celalkavlak/EE463_Hardware_Project/README.md

# EE463_Hardware_Project
Repository of EE463 Hardware Project
