celalkavlak/EE463_Hardware_Project/simulation results/sim results.docx

# SIMULATION RESULTS

## R-LOAD SIMULATION RESULTS

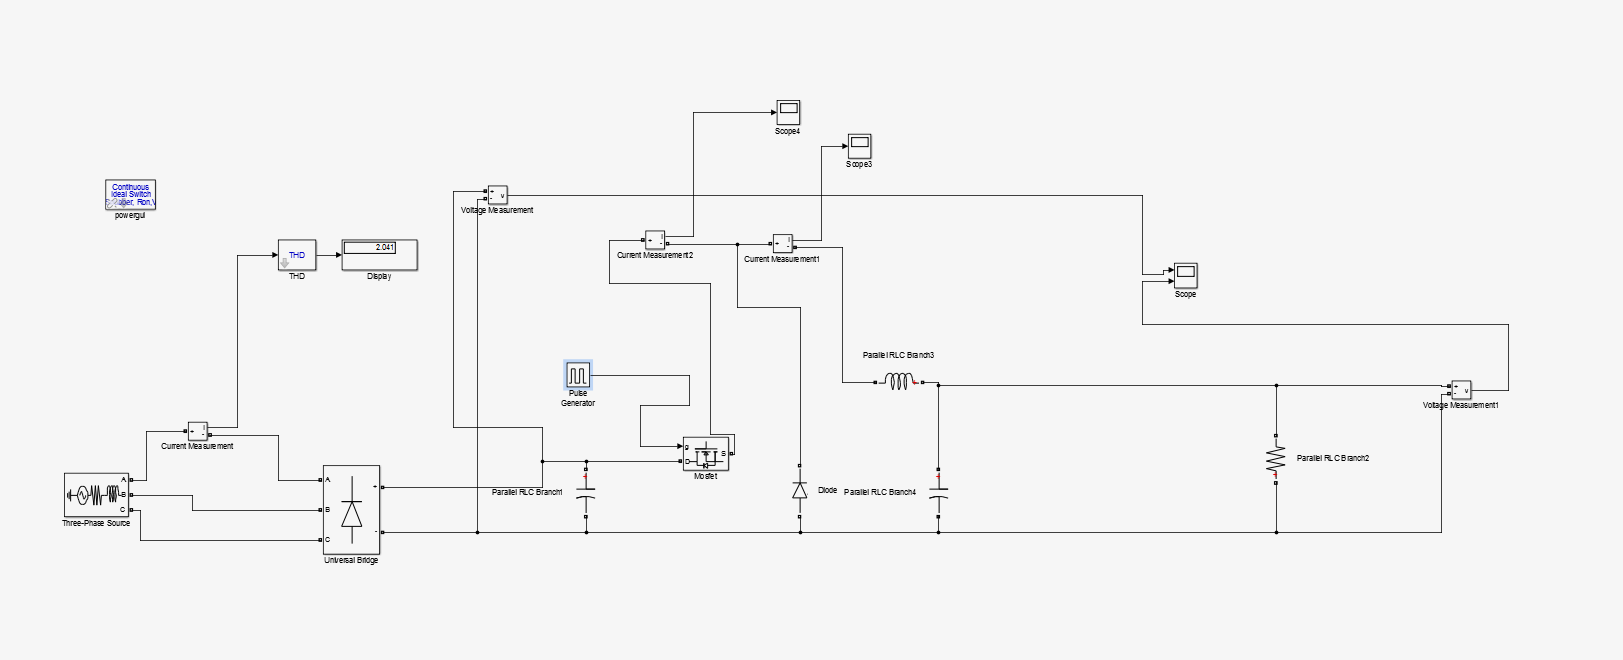
[picture p1: figure]

Figure 1. The circuit of AC to DC Motor Driver with R Load

THD is equal to %204.

The output voltage and rectifier voltage of system different with duty cycles are shown as follows;

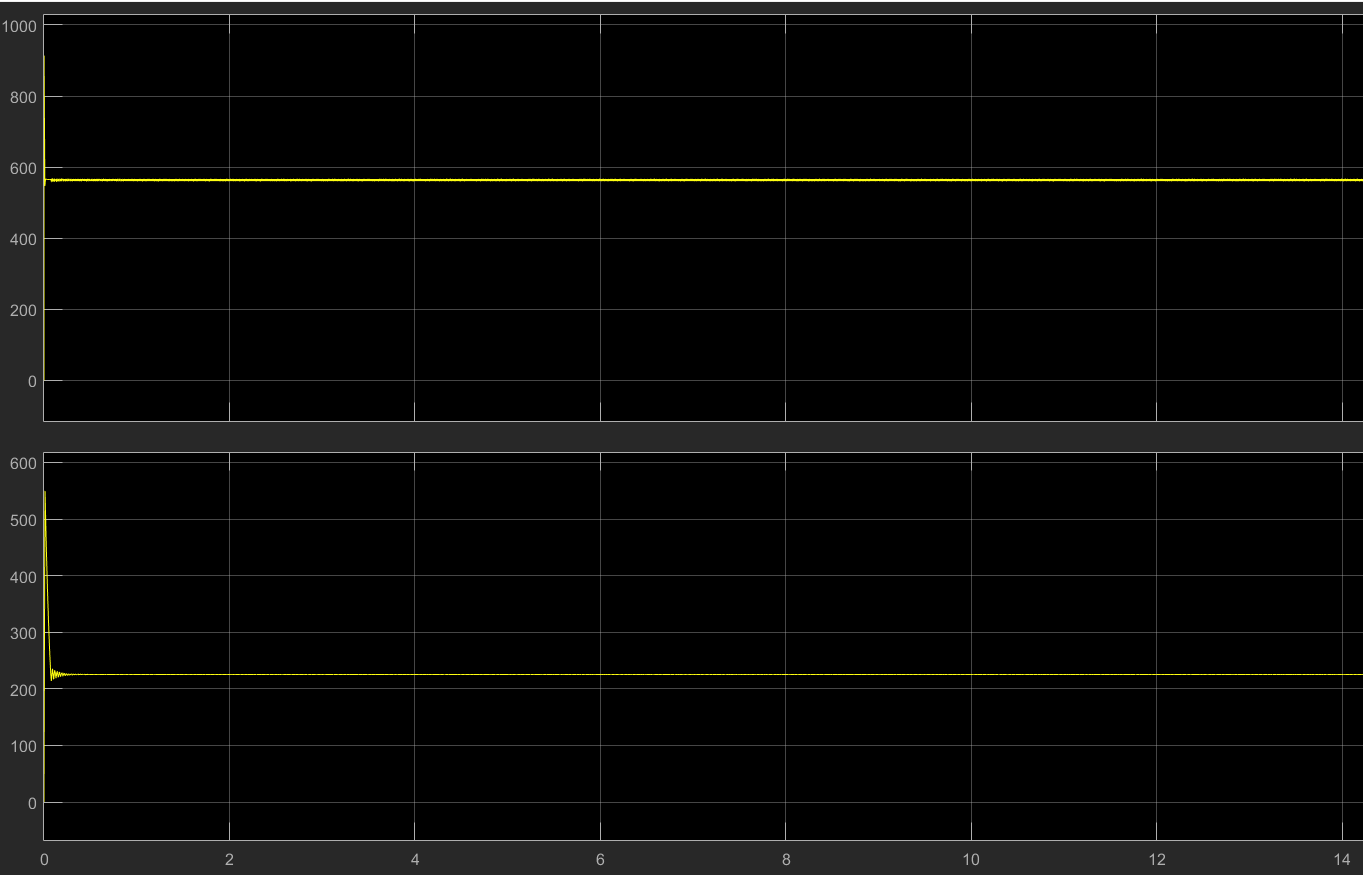
[picture p2: figure]

Figure 2.Output Voltage and Rectifier Voltages of R Load at %40 Duty Cycle

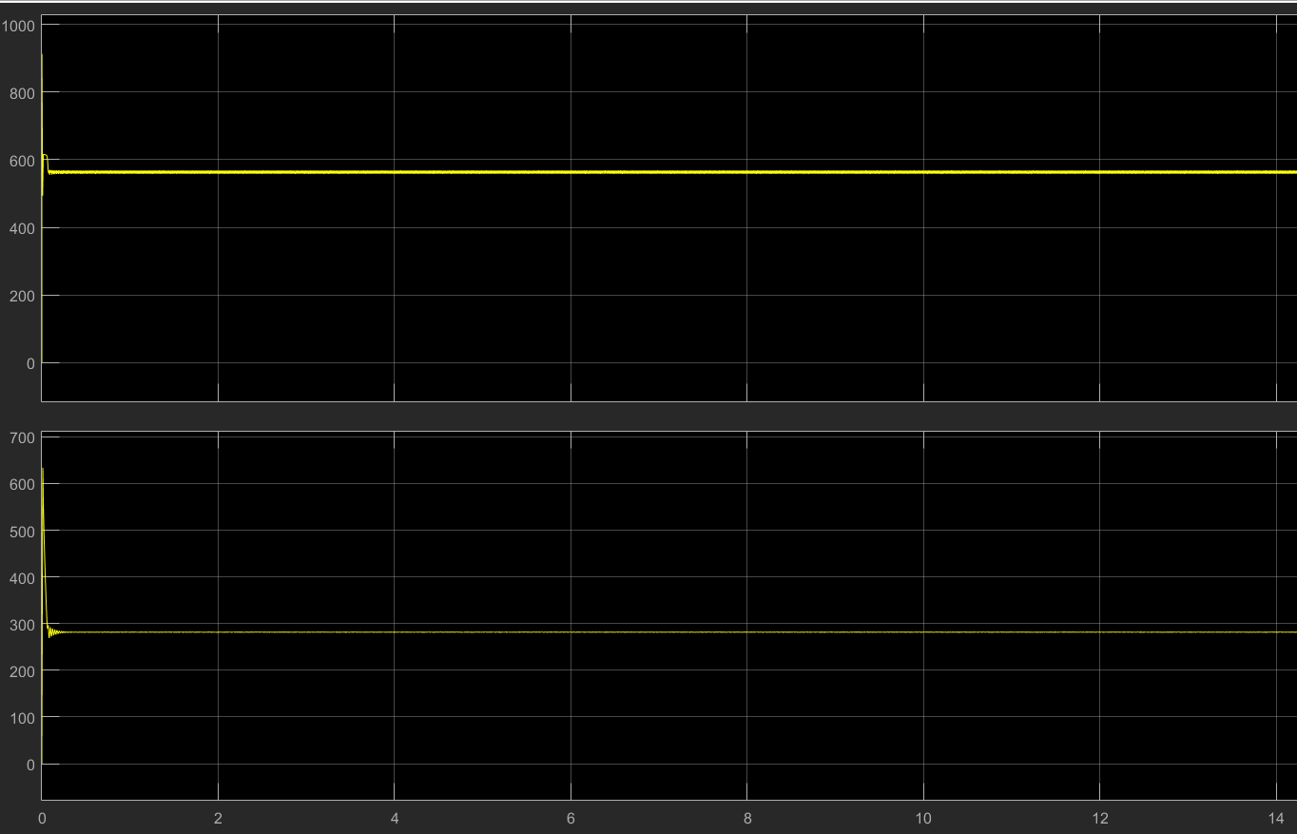
[picture p3: figure]

Figure 3.Output Voltage and Rectifier Voltages of R Load at %50 Duty Cycle

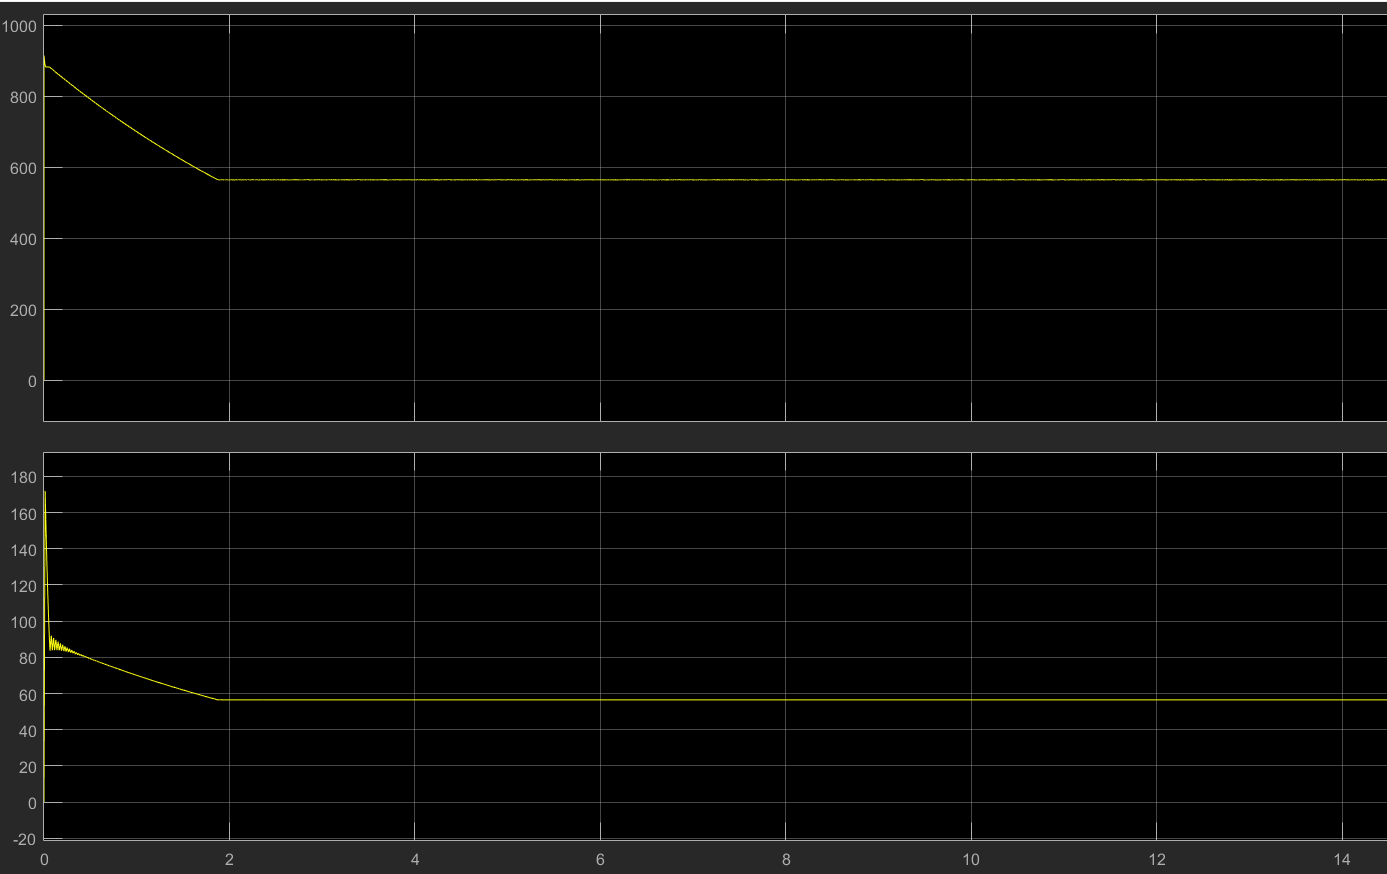
[picture p4: figure]

Figure 4.Output Voltage and Rectifier Voltages of R Load at %10 Duty Cycle
