celalkavlak/EE463_Hardware_Project/report/ee463 term project report of design and test results Abdurrahman Aydın-Tugay Karakaya- Celal Kavlak.pdf

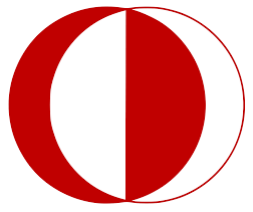
[picture p5: figure]

EE463

# STATIC POWER CONVERSION I

# REPORT OF TERM PROJECT DESIGN AND TEST RESULTS

# “AC TO DC MOTOR DRIVE”

## Abdurrahman Aydın 1936293

## Tugay Karakaya 1937069

## Celal KAVLAK 2030955

### Table of Contents

### Introduction

In this report; design decisions, computer simulations and component selection relevant to the 2017/2018 fall semester term project of Static Power Conversion I, named as AC to DC Motor Drive is provided. It is required to make a controlled rectifier that will be used drive a DC motor. The power input is three phase or one phase AC grid. The output is adjustable DC output.

### Design Decisions

In this stage, variety of different topologies is compared to reach the most efficient way to drive the DC motor at desired conditions.

### Comparison of Different Topologies

1) Single Phase Thyristor Rectifier
In thyristor rectifier, the advantage is the fact that drive is composed of fewer stages. Adjusting the average output voltage is made by setting firing angle. Moreover, in thyristor rectifiers, the motor can operate in 4th quadrant. However, gate drive of thyristor is very complicated. Generating two periodic pulse signals with 180 degree phase shift synchronized to grid oscillation frequency is very difficult. Moreover, THD reflected to grid side by single phase rectifiers are greater than three phase systems and ripple in the output voltage is larger.
2) Three Phase Thyristor Rectifier
In this topology, two more thyristors is necessary; however, greater DC output voltage can be acquired from 400 V low voltage system. Ripple in the output voltage is smaller than The disadvantage of difficulty of firing the thyristor is present in this topology, too. Thyristors must be fired one time in a period (50 Hz) with 60 degree phase shift between each other.
3) Three Phase Diode Rectifier + Buck Converter
In this topology, gate driver design of MOSFET in buck converter is much easier than that of thyristors in controlled rectifiers. Gate driver signal of MOSFET can be supplied by simple microcontrollers like Arduino Uno. By increasing the frequency of the gate signal, size of the passive components of buck converter reduces.

As a result, it is decided to use three phase diode rectifier+buck converter topology because of easiness of gate driver circuitry.

### Design

Our design consists of three parts:

- Three Phase Bridge Rectifier
- DC Link Capacitor
- Buck Converter

Three phase bridge rectifier is widely used six pack rectifier, which is used to rectify three phase AC voltage to DC voltage with average value of 1.35*Vll. DC link capacitor is chosen by taking 300 Hz ripple on the rectifier output voltage into consideration. By the help of simulations on Simulink, 470 uF capacitance is chosen for DC link capacitor to smooth the ripple on rectifier output voltage.

In buck converter, power MOSFET is used for switching. Arduino Uno+ photocoupler is used for gate driver in order to be able to supply enough current for gate-source capacitance and isolate Arduino from main circuit. The photocoupler circuitry can be seen at Figure 2. Duty cycle of the PWM supplied to gate of MOSFET determines the ratio between output voltage of converter and input voltage of the converter. The frequency of the switching is kept as high as possible in order to reduce the ripple on the inductor current. However, switching losses should not be neglected. Therefore, frequency of 31250 Hz is used to keep balance between these two concerns. It is planned to have 680uF capacitor and 1mH in buck converter for low pass filter. In the process of choosing these parameters, critical frequency of the filter and minimization of cost is taken into consideration. Our inductor is decided to wound by group members because no inductor with demanded specifications is present in the market. It is planned to have at least 1mH inductance. However, our ferrite core could go up 2.5 mH without core saturation. Therefore, we used 2.5 mH, which decreases critical frequency of the filter.

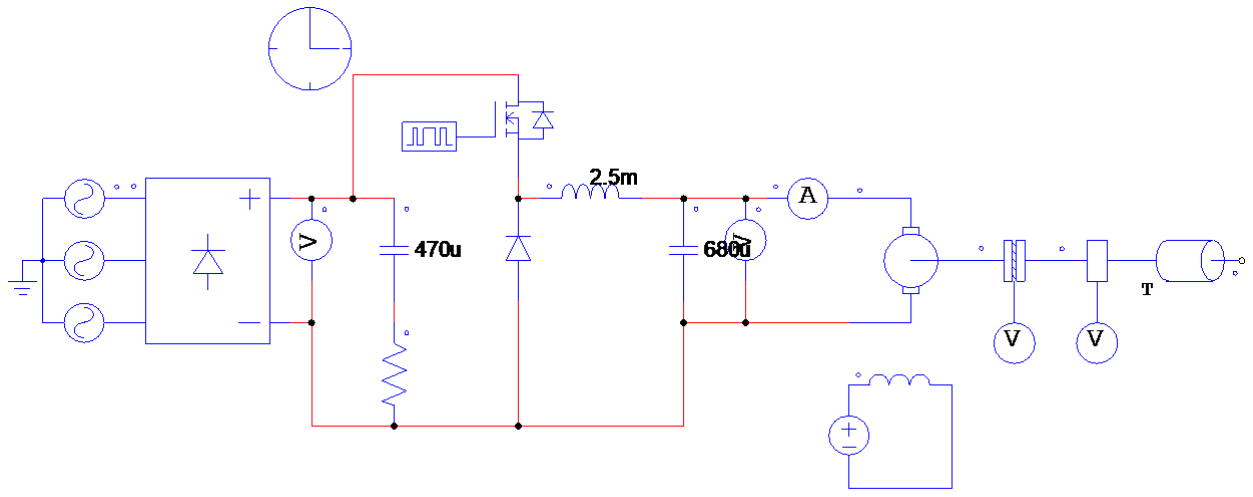
[picture p6: figure]

Figure 1: Schematic of the AC to DC Motor Drive

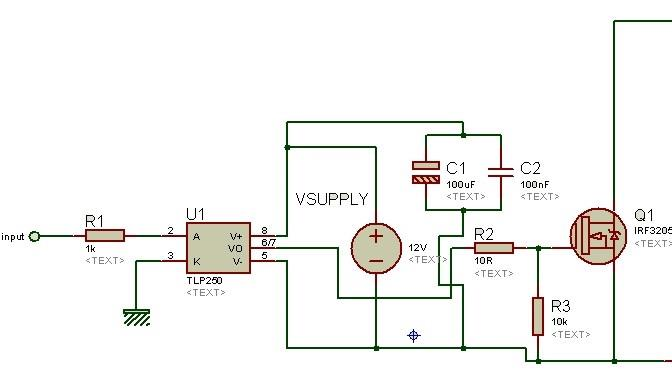
[picture p7: figure]

Figure 2: Photocoupler Circuitry[1]

### Component Selection

### Full Bridge Rectifier

SKBPC3516[2] model three phase full bridge rectifier is used with features of maximum peak reverse voltage of 1600 V and 35 A maximum average output voltage, which is much sufficient for our operation. Large heatsink is used to cool this component.

### Power MOSFET

IRFP460[3], Rds(on) is 0.27 Ω, Vds limit is 500 V, continuous drain current at 100 °C is 13 A. Switching loss increases with increasing switching. Therefore, it would be better to operate MOSFET at lower frequencies instead of 31250 kHz. Large heatsink and a fan are used to cool down this component.

### TLP250 (photocoupler)[4]

Maximum output current is 1.5 A. Supply voltage is 10-35 V, which is suitable for gate drive of MOSFET.

### Freewheeling Diode

Fast Recovery Epitaxial Diode- DSEI 30[5], which has negative termal coefficient. This feature is useful for power circuit elements. Forward voltage is about 1.3-1.5 V under 3 A. Maximum reverse voltage is 600V and maximum forward current is 37 A, which is suitable for our operation. Small heatsink is used to cool this component.

### DC Link Capacitor

Hitano’s 470 uF 450 V DC capacitor is used. For DC link voltage, 300 V is set as maximum and 150 V is left for safe operation.

### Buck Converter Inductor

2.5 mH inductor’s saturation current is experimentally tested. It can work under 2 A, which is suitable for no load operation of motor.

### Buck Converter Capacitor

Kendeil’s 680uF 400 V DC capacitor is used. For buck converter output voltage, 220 V is set as maximum and 180 V is left for safe operation.

### Computer Simulation

### R-Load Simulation Results

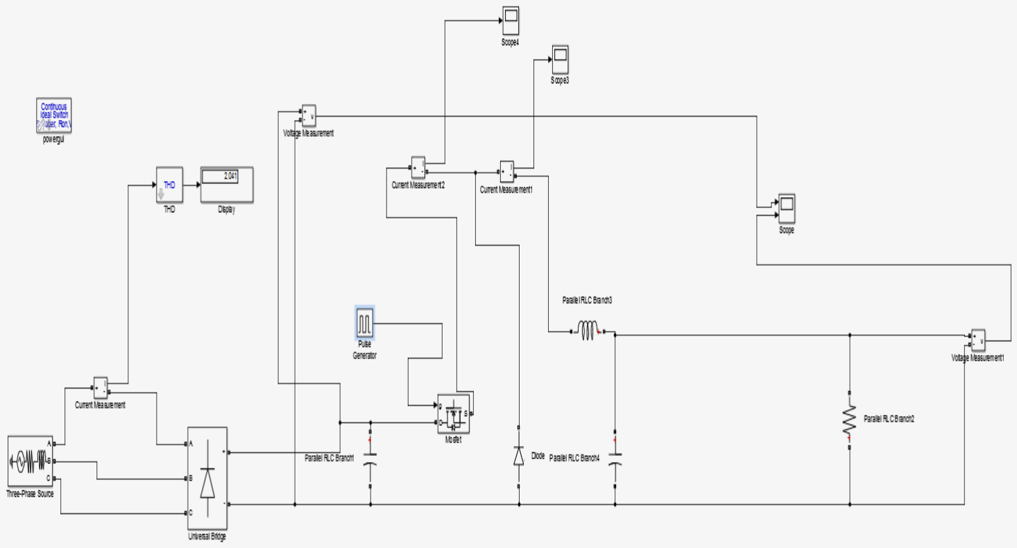
[picture p8: figure]

Figure 3: The Circuit of AC to DC Motor Driver with R Load

THD is equal to %204.

The output voltage and rectifier voltage of system different with duty cycles are shown as follows;

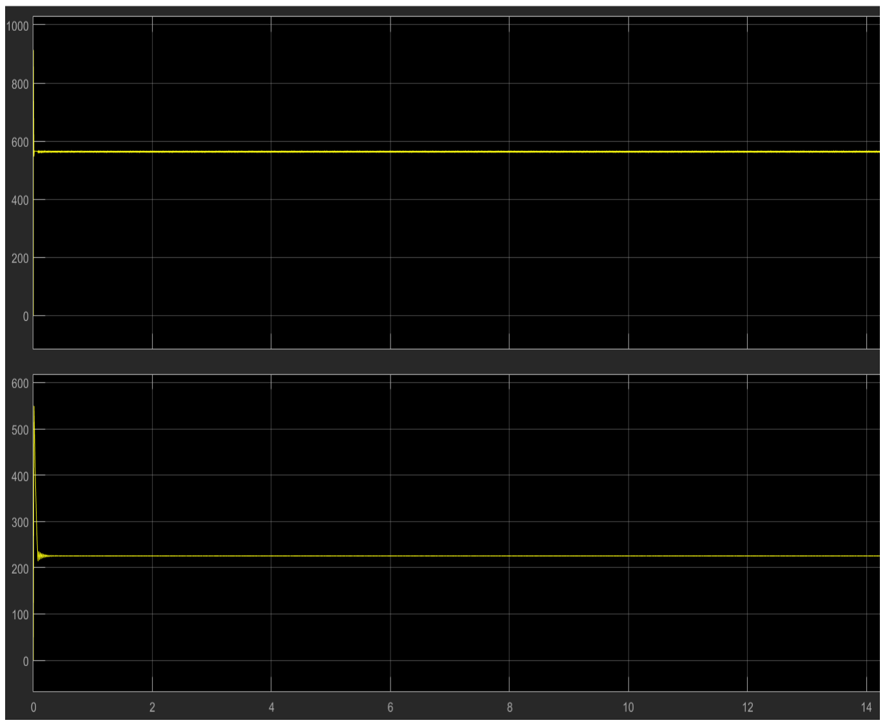
[picture p9: figure]

Figure 4: Output Voltage and Rectifier Voltages of R Load at %40 Duty Cycle

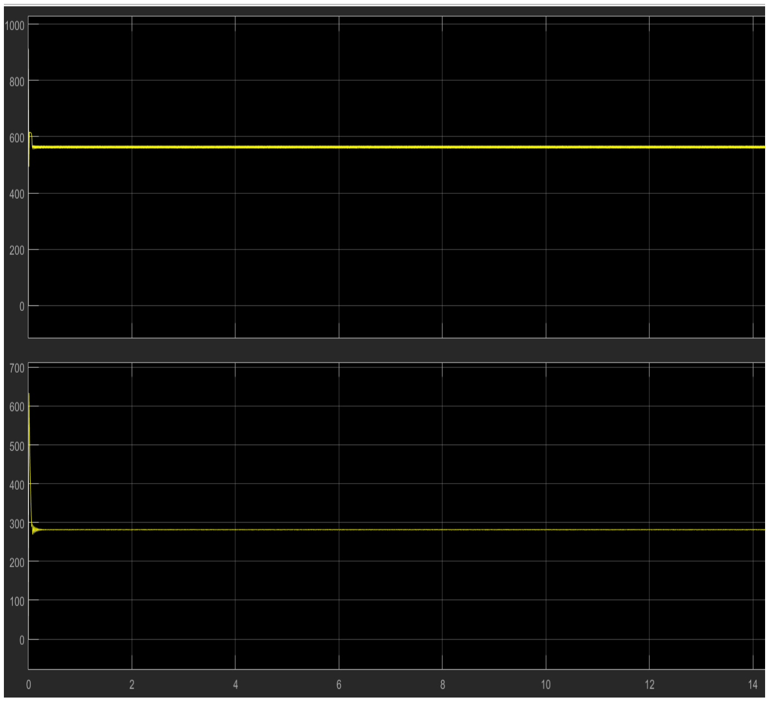
[picture p10: figure]

Figure 5: Output Voltage and Rectifier Voltages of R Load at %50 Duty Cycle

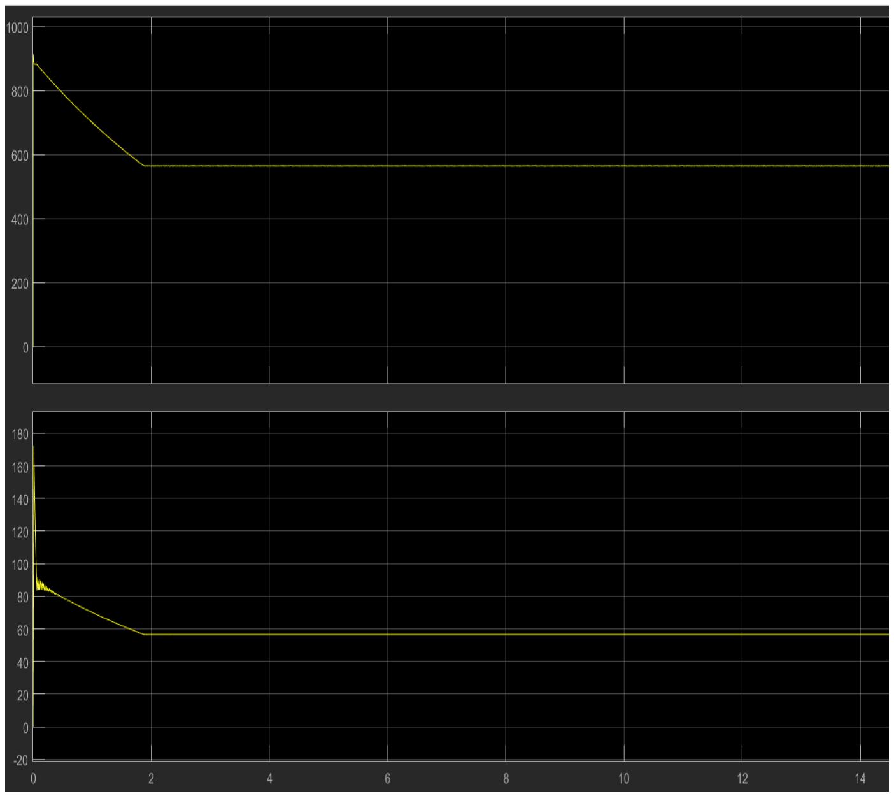
[picture p11: figure]

Figure 6: Output Voltage and Rectifier Voltages of R Load at %10 Duty Cycle

As expected, rectifier voltage is proportional to the duty cycle.

### Running Motor at No Load Simulation Results

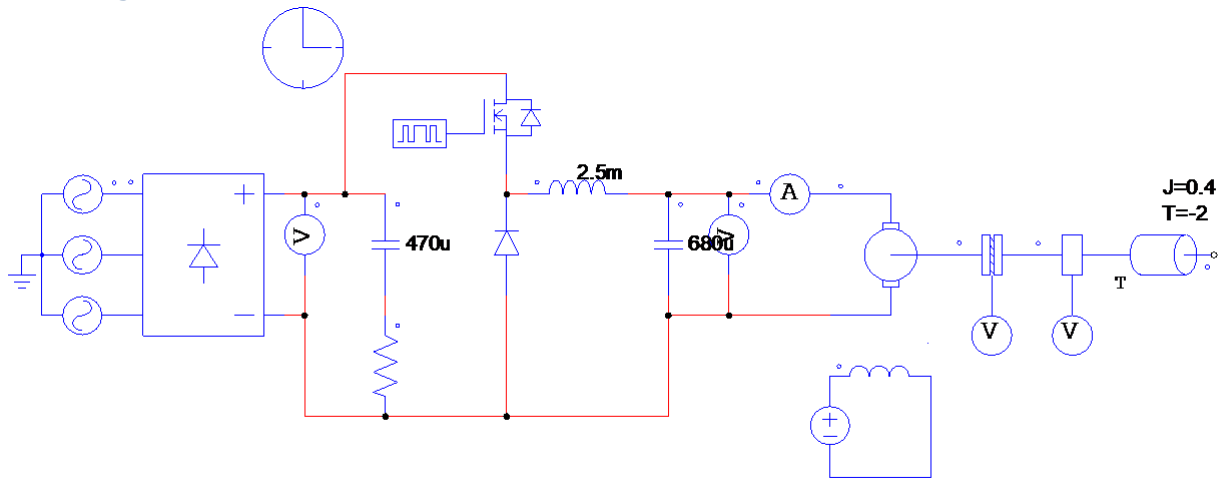
[picture p12: figure]

Figure 7: Schematic of the Drive Circuit

1)For Duty Cycle of 0.9

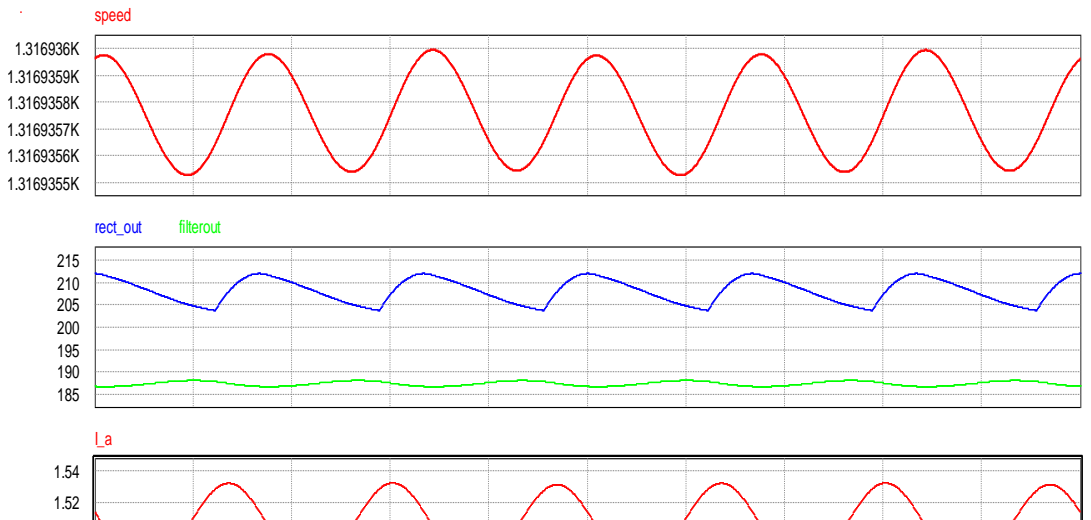
[picture p13: figure]
speed; rect_out; filterout

Figure 8: Speed of the DC Motor,Rectifier and Buck Converter Output Voltage, Armature Current Waveforms for D=0.9

50.98 | 50.982 | 50.984 | 50.986 | 50.988 | 50.99 | 50.992 | 50.994 | 50.996 | 50.998 | 51
| | | | | Time (s)

1.46

1.48

1.5

Figure 9: Input Current and Voltage Waveforms for D=0.9

Input current’s THD is equal to 187%, input power is equal to 93.9 W*3=281.7 W, which is consistent with the output power 187 V*1.5A=280.5 W

2)For Duty Cycle of 0.5

Figure 10: Speed of the DC Motor,Rectifier and Buck Converter Output Voltage, Armature Current Waveforms for D=0.5

50.98 | 50.982 | 50.984 | 50.986 | 50.988 | 50.99 | 50.992 | 50.994 | 50.996 | 50.998 | 51
| | | | | Time (s)

0

-100

-200

100

200

VP2 | I2*20

724.50365

724.5037

724.50375

724.5038

724.50385

724.5039

724.50395

speed

100

120

140

160

180

200

220

rect_out | filterout
50.98 | 50.982 | 50.984 | 50.986 | 50.988 | 50.99 | 50.992 | 50.994 | 50.996 | 50.998 | 51
| | | | | Time (s)

1.495

1.5

1.505

1.51

1.515

1.52

I_a

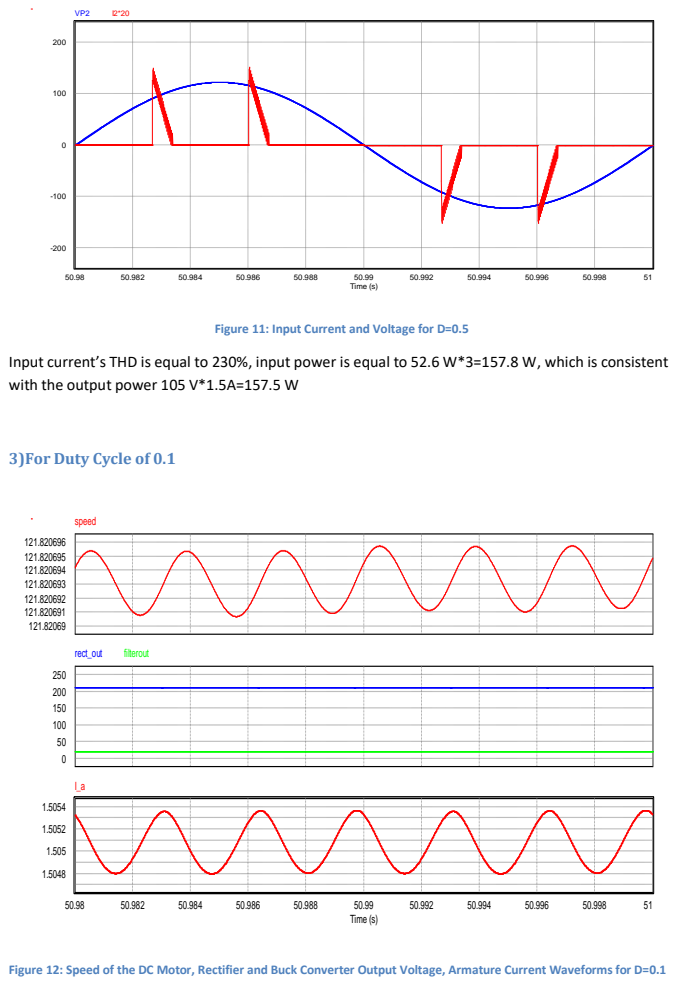
[picture p14: page 13]
Time (s); speed; rect_out; filterout

Figure 11: Input Current and Voltage for D=0.5

Input current’s THD is equal to 230%, input power is equal to 52.6 W*3=157.8 W, which is consistent
with the output power 105 V*1.5A=157.5 W

3)For Duty Cycle of 0.1

Figure 12: Speed of the DC Motor, Rectifier and Buck Converter Output Voltage, Armature Current Waveforms for D=0.1

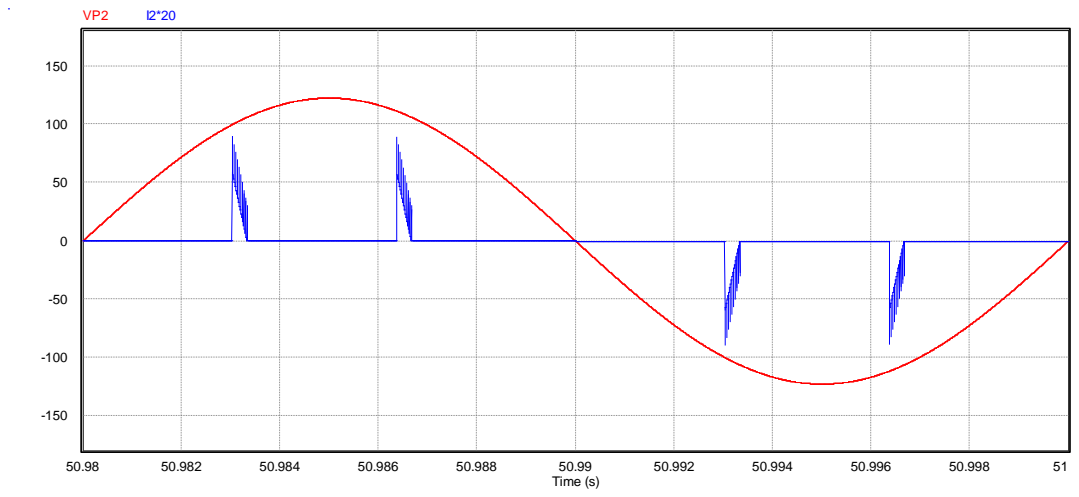
[picture p15: figure]
Time (s)

Figure 13: Input Current and Voltage Waveforms for D=0.1

Input current’s THD is equal to 370.4%, input power is equal to 10.64W*3=31.92 W, which is consistent with the output power 21 V*1.5A=31.5 W

As seen from Figure 4,5 and 6; rectifier output voltage decreases with decreasing duty cycle of gate drive, and motor speed decreases with decreasing duty cycle. Very small oscillation with frequency of 300 Hz can be seen on waveforms which cannot be filtered by DC-link capacitor and low pass filter of buck converter.

### Tests Results

In order to run the TLP 250 and cooling fan, 12 V DC source is used in setups.

### Component Tests

1)Inductor
Measurement of inductance;

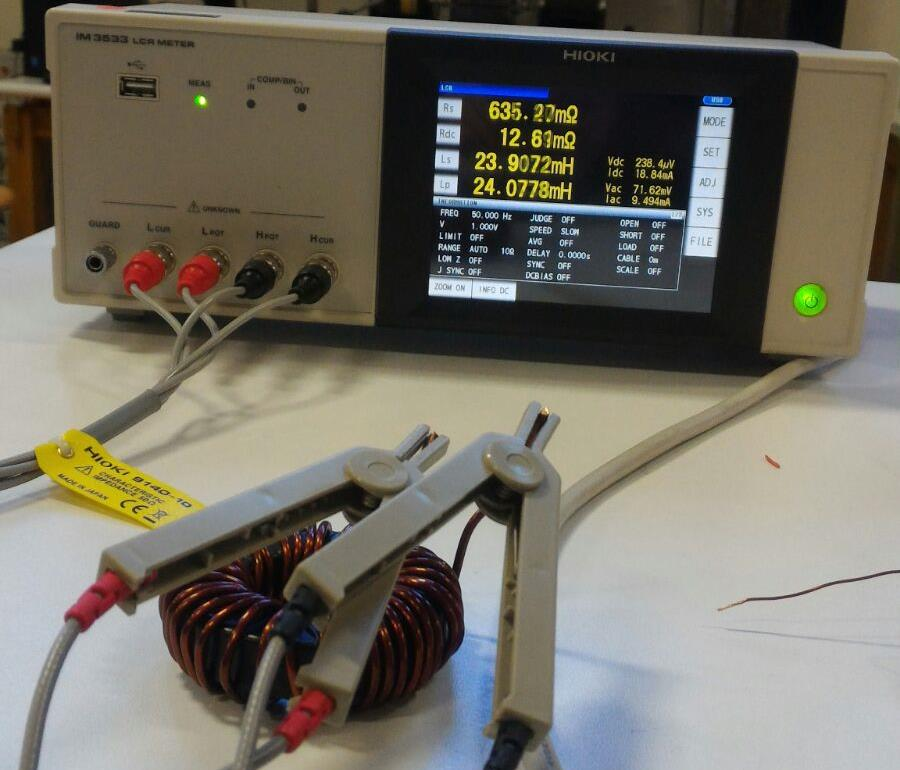
[picture p16: figure]

Figure 14: Inductance of Component Planned to Use in Buck Converter

Saturation of inductor;

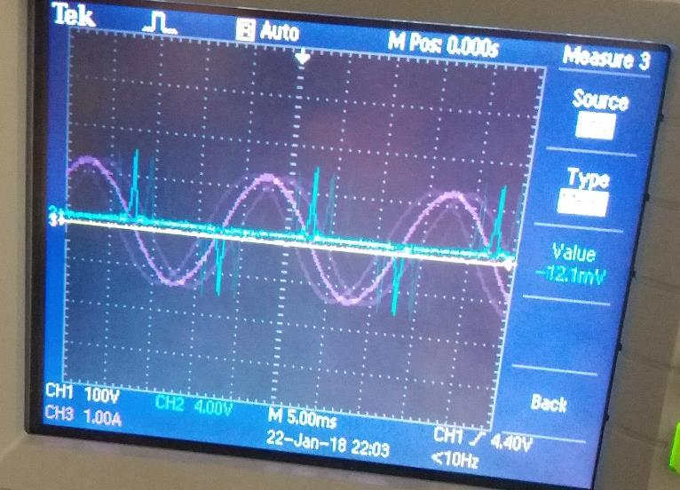
[picture p17: figure]

Figure 15: Saturation of Inductor Experimental Result

The inductor in Figure X is in the saturation, whose voltage (CH2) –current (CH3) graph can be seen in Figure X+1. Therefore, winding turn of inductor is reduced and inductor with 2.5 mH inductance is used in circuit.

2)TLP250 Tests (Duty Cycle and PWM)

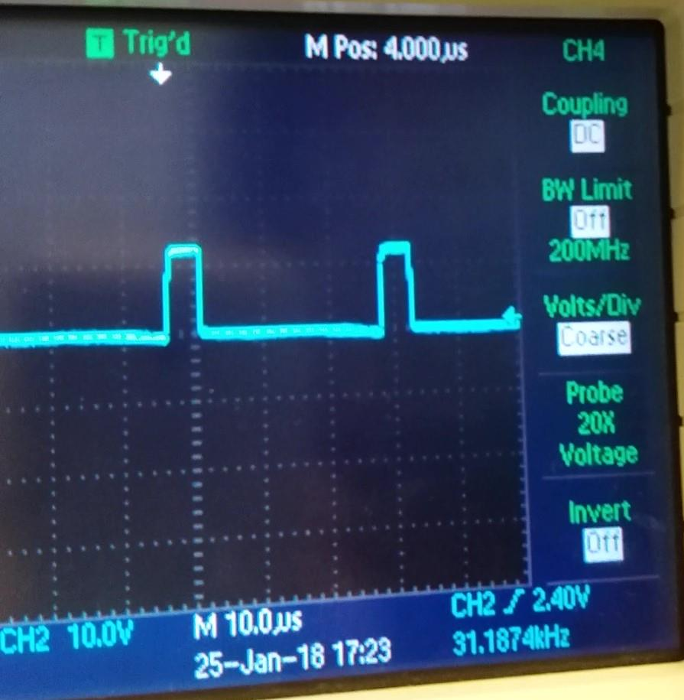
[picture p18: figure]

Figure 16: Output of TLP250 Duty Cycle at %15

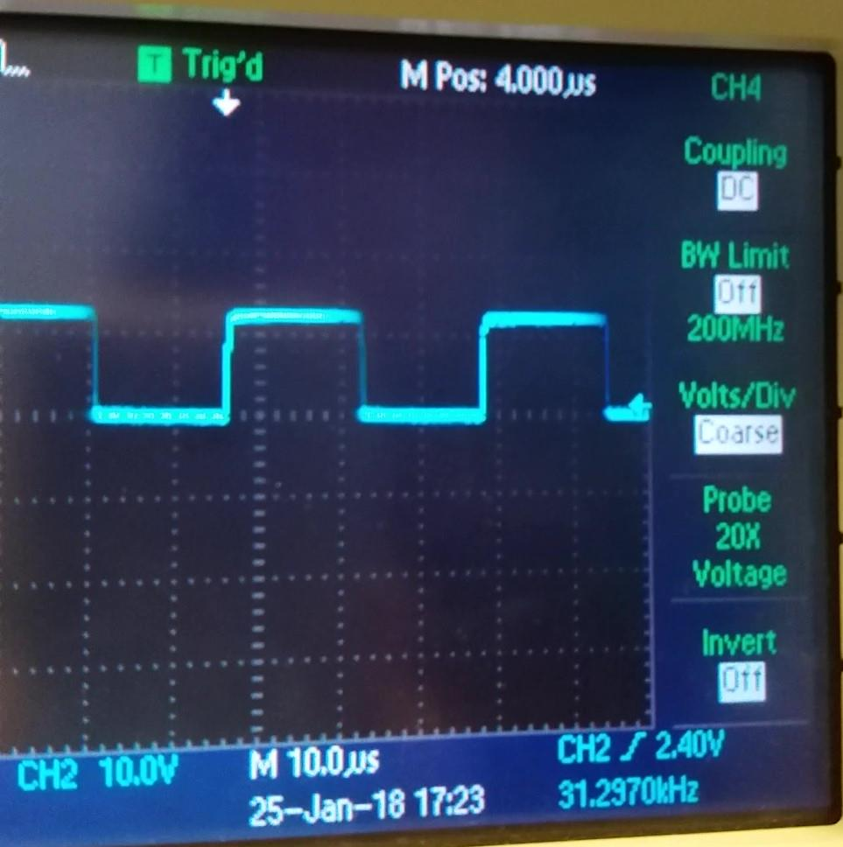
[picture p19: figure]

Figure 17: Output Waveform of TLP250 Duty Cycle at %50

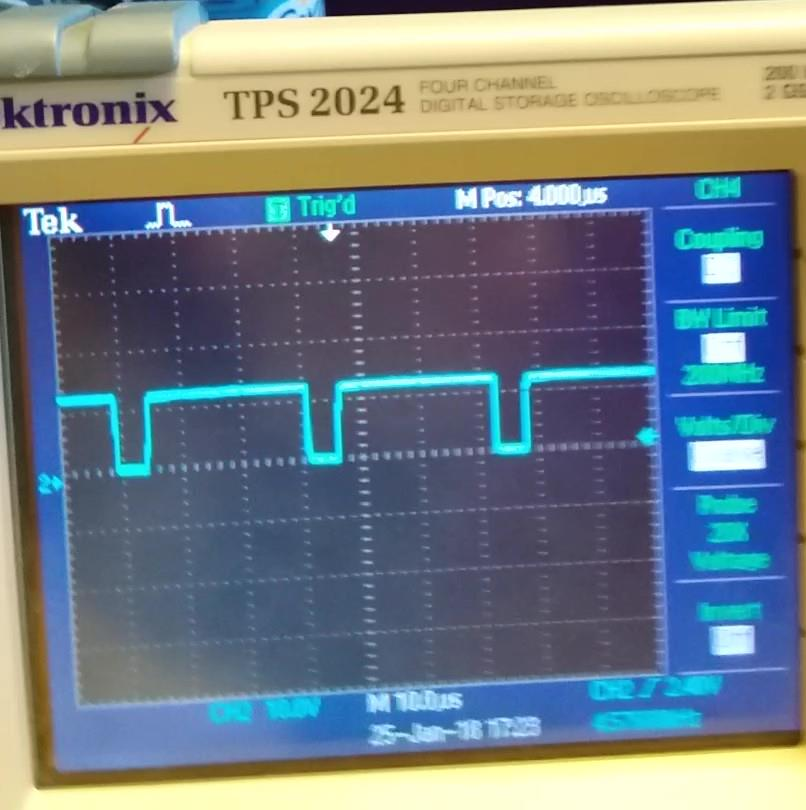
[picture p20: figure]

Figure18: Output Waveform of TLP250 Duty Cycle at %90

TLP250 is tested under resistive load. As duty cycle of PWM coming from Arduino is increased, duty cycle of TLP250 increases.

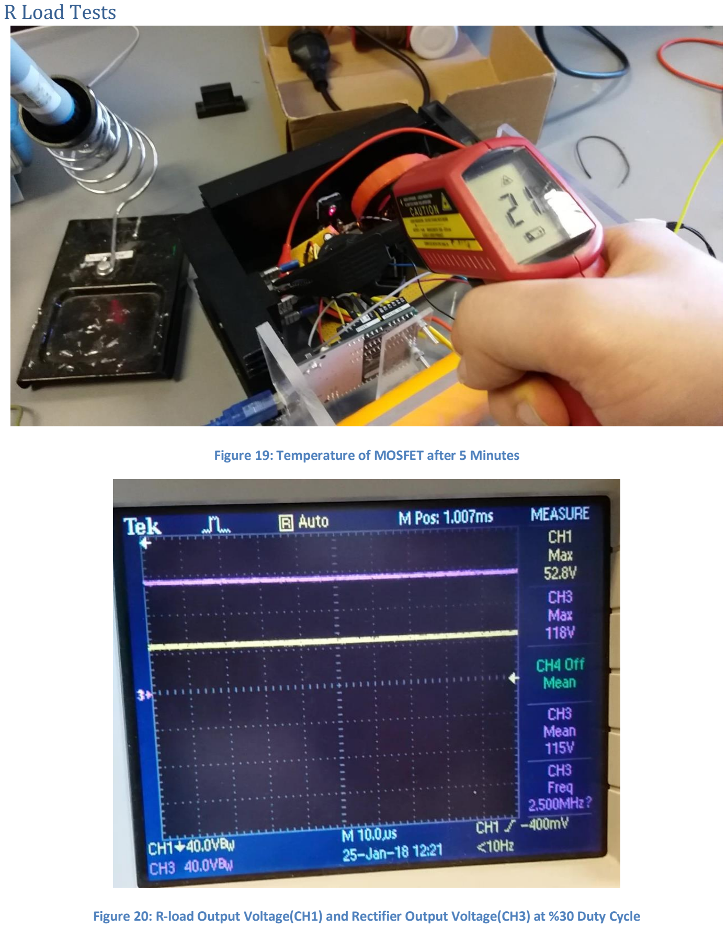
[picture p21: page 19]

### R Load Tests

Figure 19: Temperature of MOSFET after 5 Minutes

Figure 20: R-load Output Voltage(CH1) and Rectifier Output Voltage(CH3) at %30 Duty Cycle

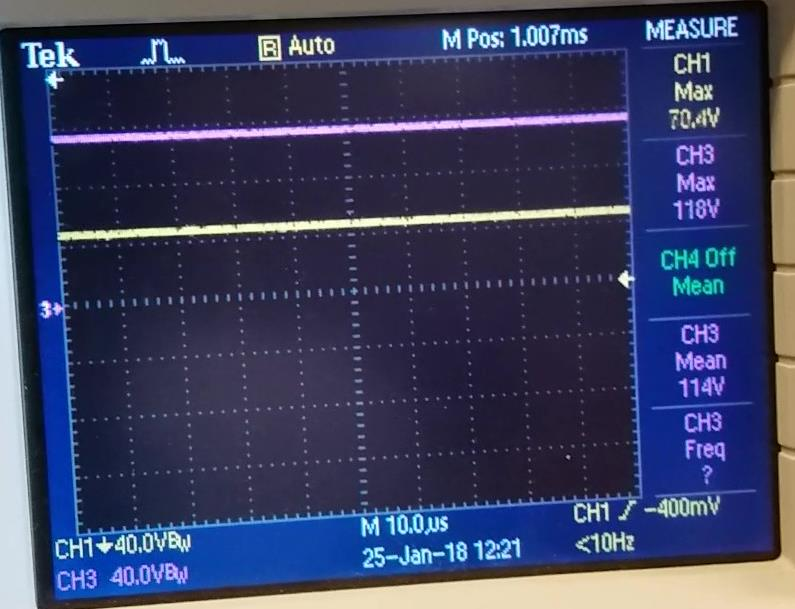
[picture p22: figure]

Figure 21: R-load Output Voltage(CH1) and Rectifier Output Voltage(CH3) at %60 Duty Cycle

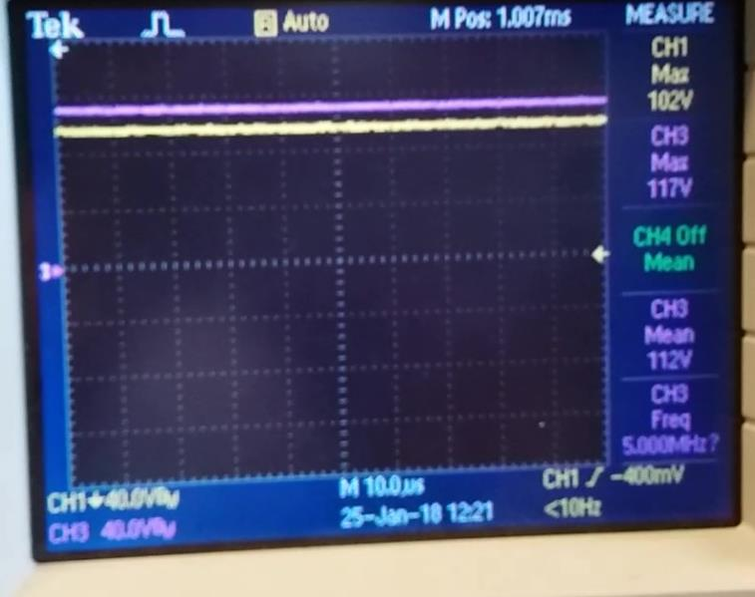
[picture p23: figure]

Figure 22: R-load Output Voltage(CH1) and Rectifier Output Voltage(CH3) at %90 Duty Cycle

Similar to the simulation results, buck converter voltage is increasing with increasing duty cycle of gate drive voltage.

### Motor Tests

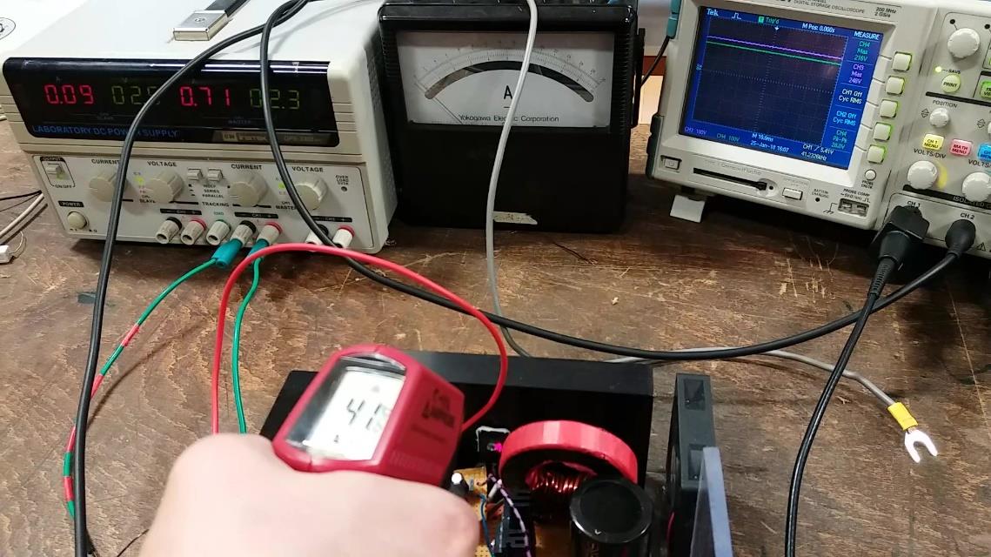
[picture p24: figure]

Figure 23: Temperature of MOSFET after 5 minutes (Motor at 220 V, with armature current of 1.6 A)

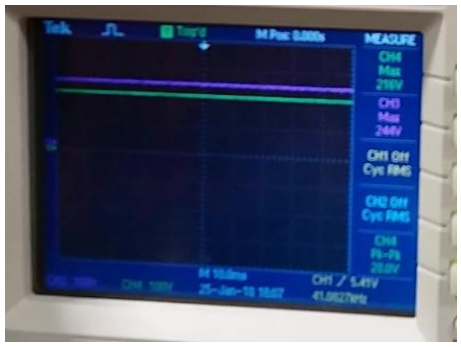
[picture p25: figure]

Figure 24: Output Voltage and Rectifier Output Voltage at %90 Duty Cycle

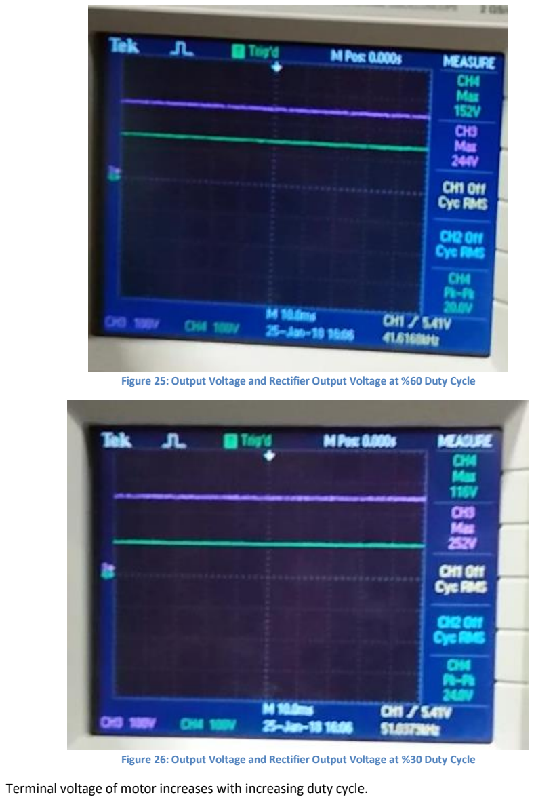
[picture p26: page 22]

Figure 25: Output Voltage and Rectifier Output Voltage at %60 Duty Cycle

Figure 26: Output Voltage and Rectifier Output Voltage at %30 Duty Cycle

Terminal voltage of motor increases with increasing duty cycle.

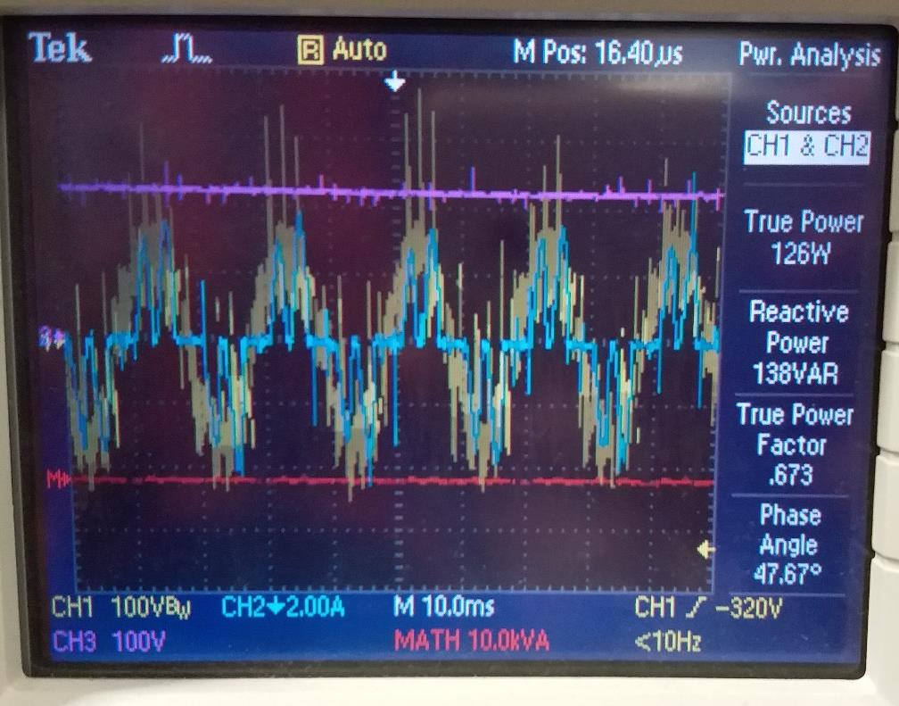
[picture p27: figure]

Figure 27: Input Power of System

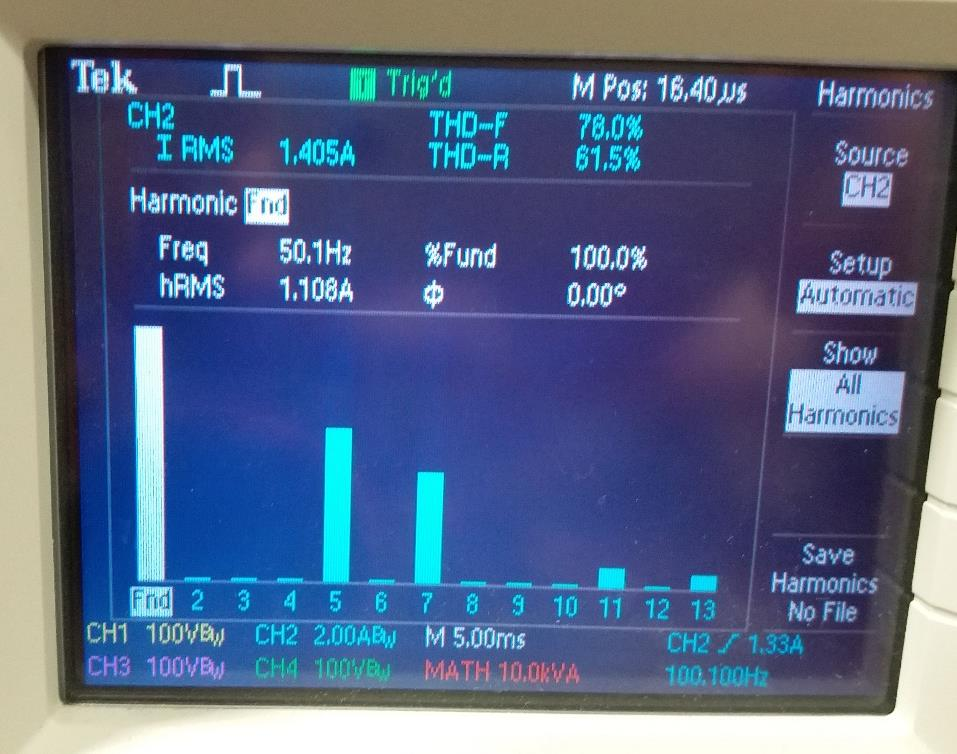
[picture p28: figure]

Figure 28: THD of Input Current

True power is 126 W for each phase and total true power is 126*3=378 W (Figure 28) at no load condition and Vt=220 V. Armature current is equal to about 1.6 A (Figure 29). Then, Output power is equal to 1.6*220 = 352 W. Power loss is 378-352=26 W. To remove this heat loss, proper heatsinks and fan combination is used. Efficiency is (352/378)*100= 93.12%. This loss is not seen in simulations because we use ideal components in simulations.

THD of line current is 78%, which is due to high capacitance of DC link capacitor, it distorts the input current. However, measured THD is not as high as in simulations because of line inductance in real.

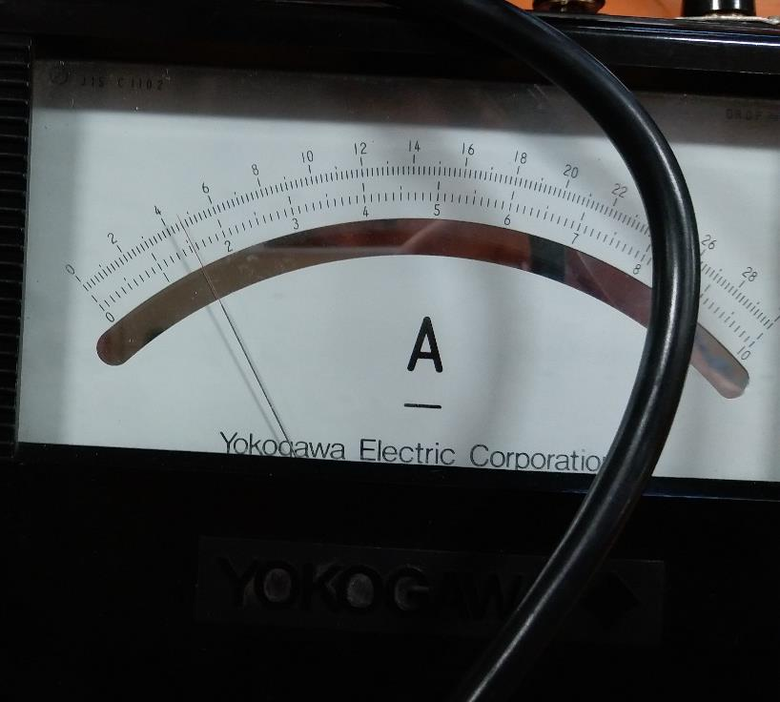
[picture p29: figure]

Figure 29: Output Current of System (Armature Current) When Output Voltage (Terminal Voltage) is 220V

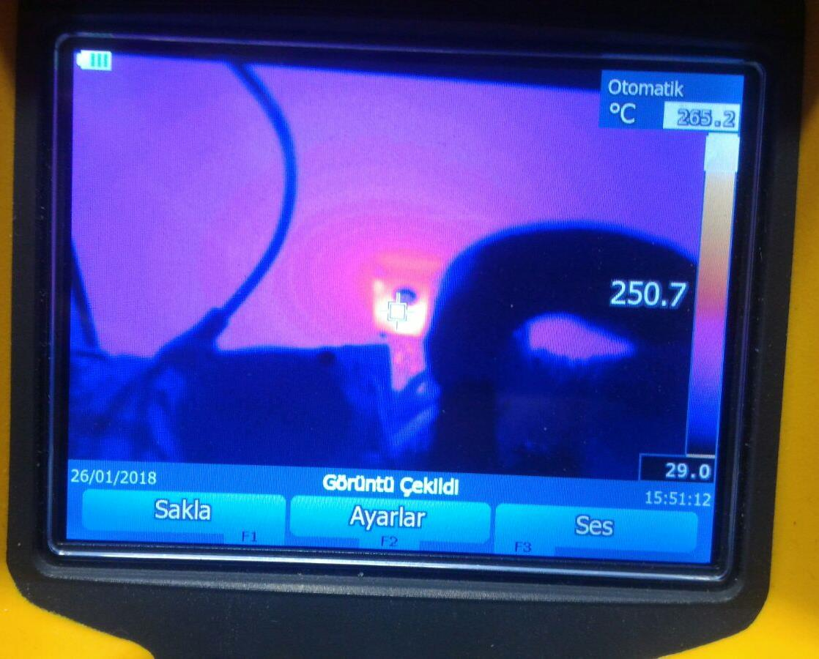
[picture p30: figure]

Figure 30: Temperature of MOSFET after 30 Seconds of Full Load Operation (12.7 A armature current)

At demonstration, robust design bonus is tried and failed. The failed MOSFET is seen at the Figure 30 at 250 °C.

### Conclusion

In this hardware project, we observed AC to DC motor drive with different speeds. The speed is

adjusted according to DC output of our setup. We observed simulation results and experimental

results are similar but not same. Also, we learned that using material is very important for hardware

project. Moreover, we learned that we do not trust sellers, especially in Konya Street. We should

search correct component for our system otherwise we can encounter some problems such as

shorting(MOSFET drain to source) or burning our components. In addition, we did not observe any

problem theoretically or on simulation works. However, we can encounter some problems in

practical. Therefore, we have to test our setup again and again for taking better results and

understanding the behavior of the components. Also, we observed switching loss is big problem for

our system. Since, switching loss cause to increase temperature of our components. Therefore, we

have to control that frequency is not very high such as higher than 15 kHz. To illustrate, when we

tried to run the motor at full load with the system frequency of 31250 Hz, MOSFET’s temperature

increased to 250 °C after 30 seconds. In addition, we observed parasitic effect on our setup. The

cable can affect the system as capacitive or inductive because of length of cable. Parasitic effect

cause to some peaks in our voltage and current waveforms. This condition can damage our setup. For

overcome this problem, we should select our cable’s lengths and features carefully. To protect

components, we may use snubbers. To conclude, we got idea about making AC to DC motor drive in

all aspects. Making this setup is very difficult and it takes very long time, we think that the project is

very beneficial for us. Thanks to our instructor for this project.

### References

[1] Kim, B. I. L. A. L. Malik, Showlin, Logu, M. Anees, B. dave, Johmy, Kevin, Aks, A. sofyane, Jayateertha, and Amjad, “How to use isolated MOSFET driver TLP250,” Microcontrollers Lab, 28-Apr-2015. [Online]. Available: http://microcontrollerslab.com/isolated-mosfet-driver-tlp250/. [Accessed: 28-Jan-2018].
[2] Rectron Semiconductor,” SKBPC3504 THRU SKBPC3516” datasheet, https://www.rectron.com/public/product_datasheets/skbpc3504-skbpc3516.pdf
[3] Vishay,”Power MOSFET”,IRFP460 datasheet,[Revised Jul.2008], http://www.vishay.com/docs/91237/91237.pdf
[4] Toshiba,” Photocoupler GaAlAs Ired & Photo−IC”,TLP250 datasheet,[Revised Jun.2004], http://web.itu.edu.tr/yildiri1/mylibrary/data/tlp250.pdf
[5] IXYS,” Fast Recovery Epitaxial Diode (FRED)”, DSEI30-06A datasheet[Revised Sept.2015], http://ixapps.ixys.com/datasheet/dsei30-06a.pdf
