celalkavlak/EE463_Hardware_Project/(commit log)

2018-01-05 two different sim added for normal resistive load and with dc motor
2018-01-21 pwm code
2018-01-22 website link-pulsein function(arduino)
2018-01-28 simulation at psim after editing armature resistance and moment of inertia
